matthewjstanford/kratos-energy-monitor/photos/IMG_7349.JPG

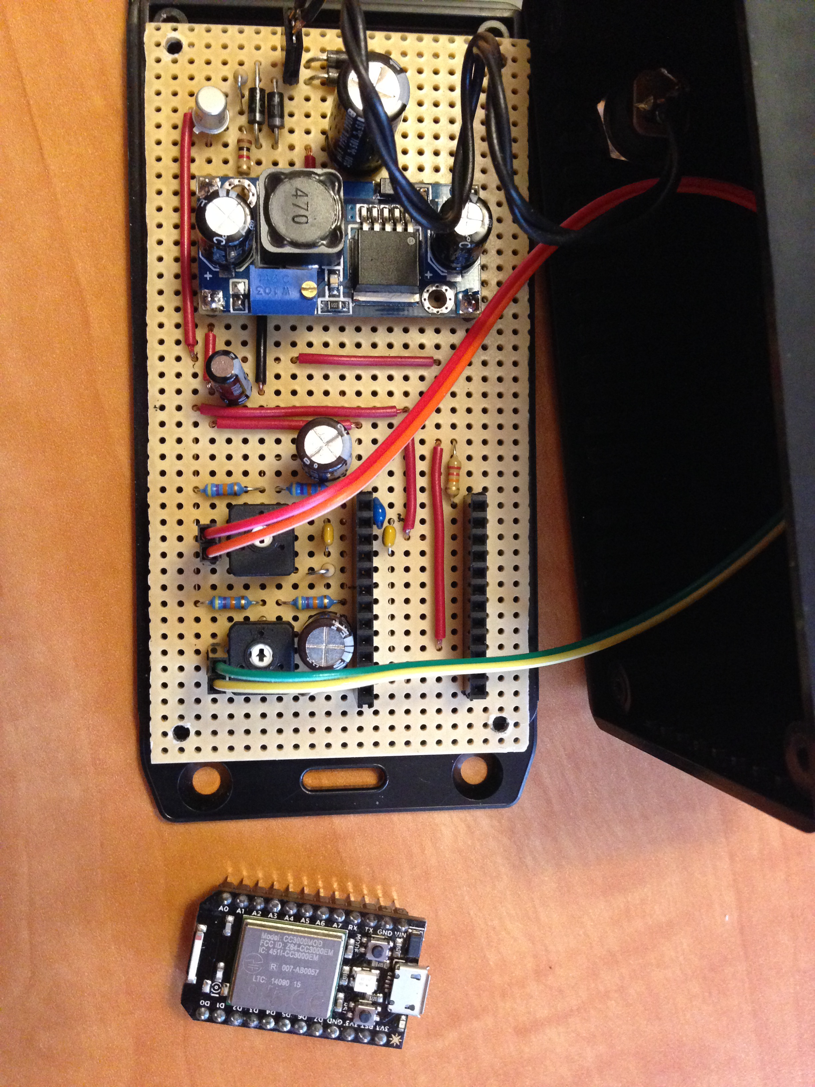
photos/IMG_7349.JPG
