matthewjstanford/kratos-energy-monitor/photos/IMG_7350.JPG

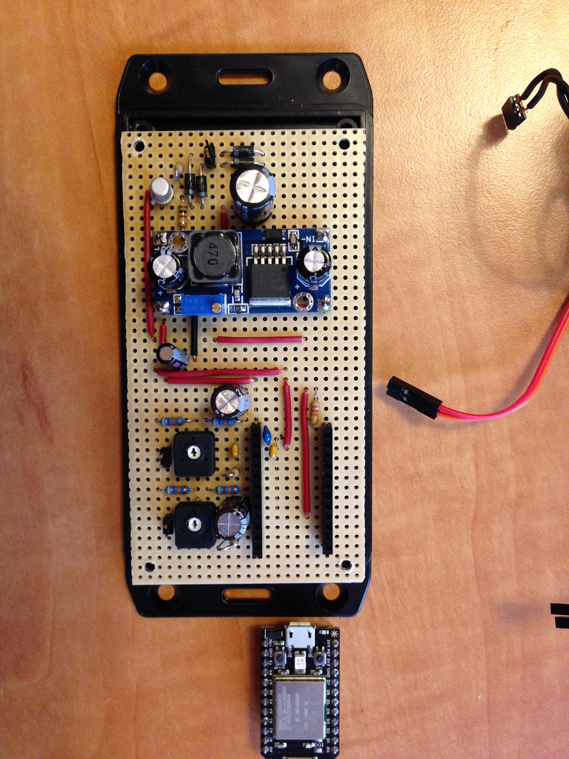
photos/IMG_7350.JPG
