matthewjstanford/kratos-energy-monitor/photos/IMG_7337.JPG

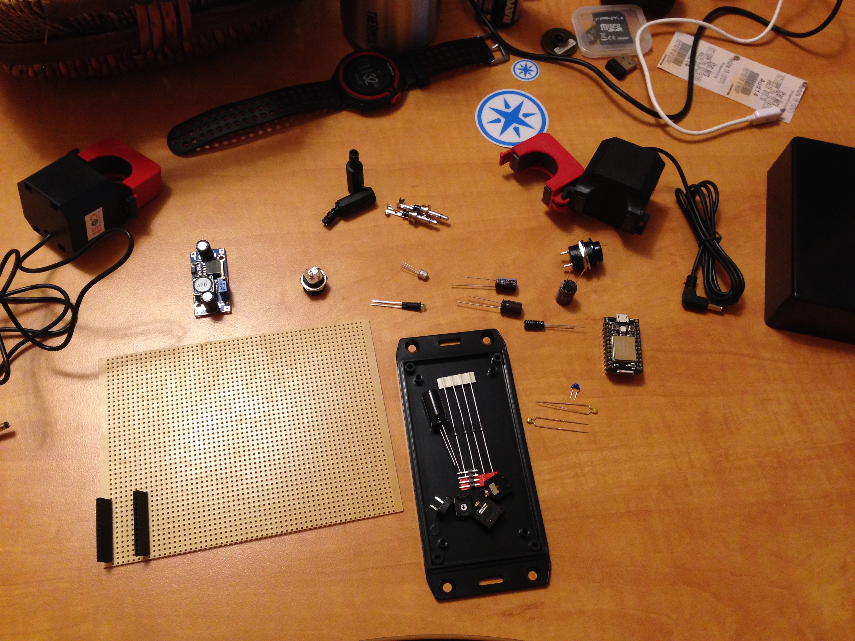
photos/IMG_7337.JPG
