matthewjstanford/kratos-energy-monitor/photos/IMG_7341.JPG

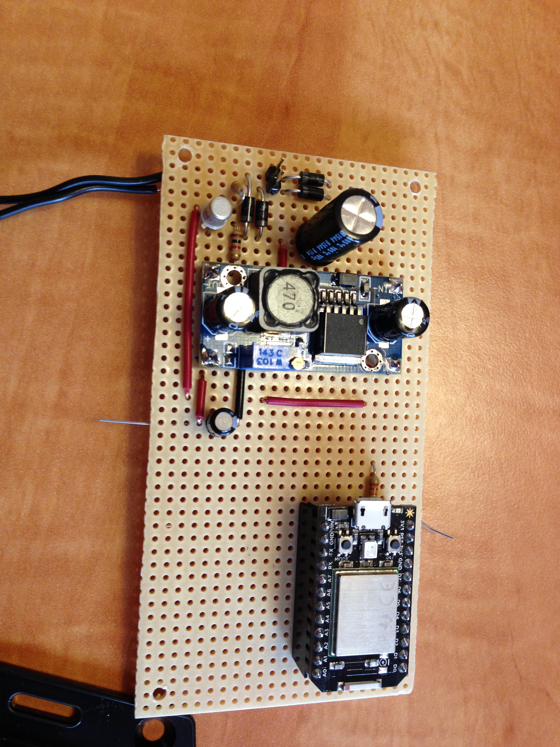
photos/IMG_7341.JPG
