matthewjstanford/kratos-energy-monitor/photos/IMG_7342.JPG

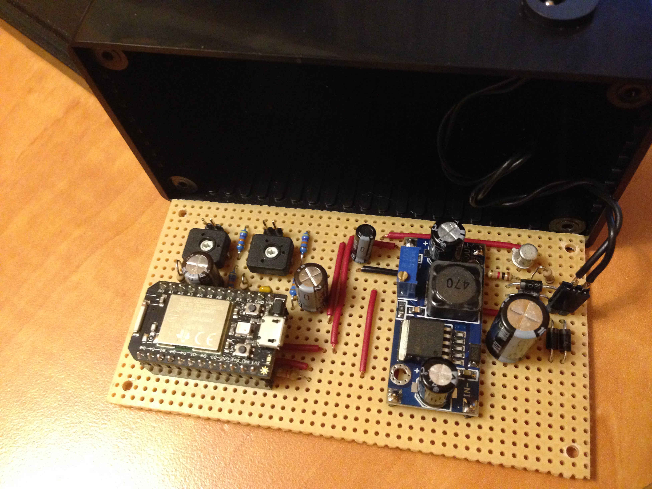
photos/IMG_7342.JPG
