matthewjstanford/kratos-energy-monitor/photos/IMG_7351.JPG

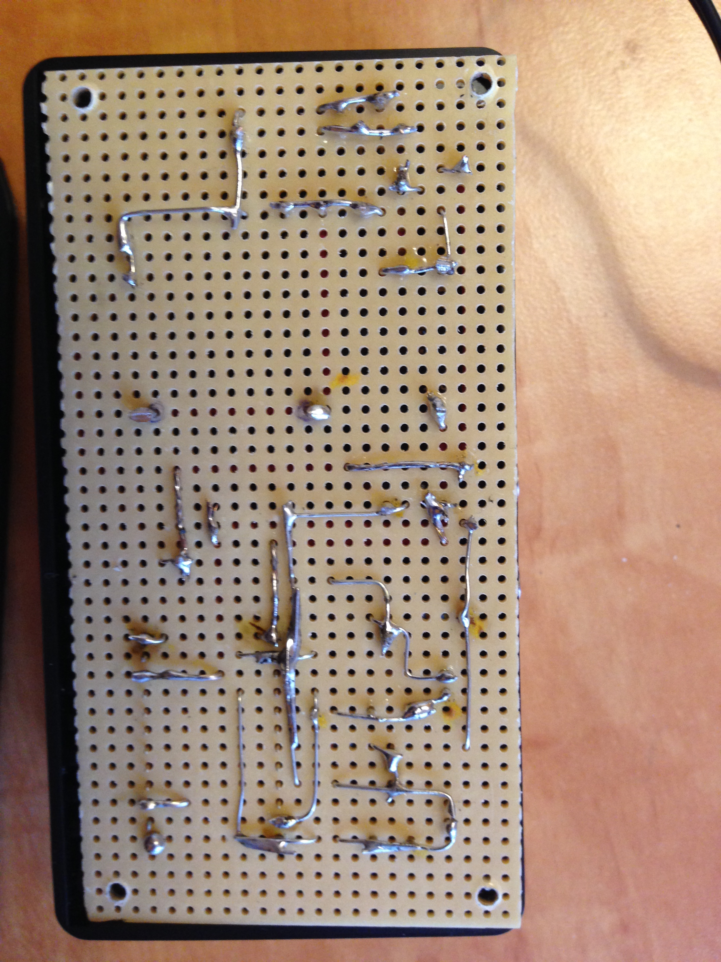
photos/IMG_7351.JPG
