matthewjstanford/kratos-energy-monitor/schematics/NCP3063-converter.sch

## EAGLE design schematics/NCP3063-converter.sch (2016-03-28)

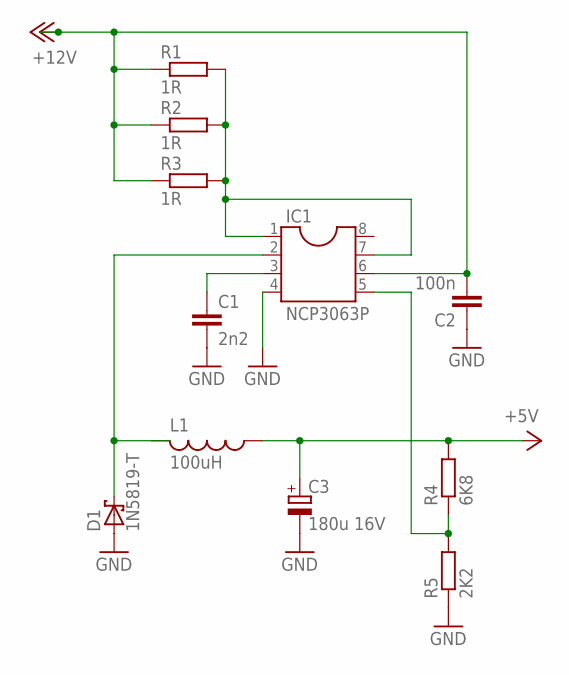
[picture p7: schematic NCP3063-converter.sch]

Parts:
C1: 2n2; C050-045X075
C2: 100n; C050-045X075
C3: 180u 16V; E5R
D1: 1N5819-T; DO41-7.6
IC1: NCP3063P; DIL08
L1: 100uH; 0207/15
R1, R2, R3: 1R; 0309/12
R4: 6K8; 0309/12
R5: 2K2; 0309/12

Connections:
+5V: C3.+, L1.1, R4.2
+12V: C2.2, R1.1, R2.1, R3.1
GND: C1.2, C2.1, C3.-, D1.A, IC1.4, R5.1
unnamed: IC1.1, IC1.7, R1.2, R2.2, R3.2
unnamed: R4.1, R5.2
