matthewjstanford/kratos-energy-monitor/schematics/Spark-power-meter-main.sch

## EAGLE design schematics/Spark-power-meter-main.sch (2016-03-28)

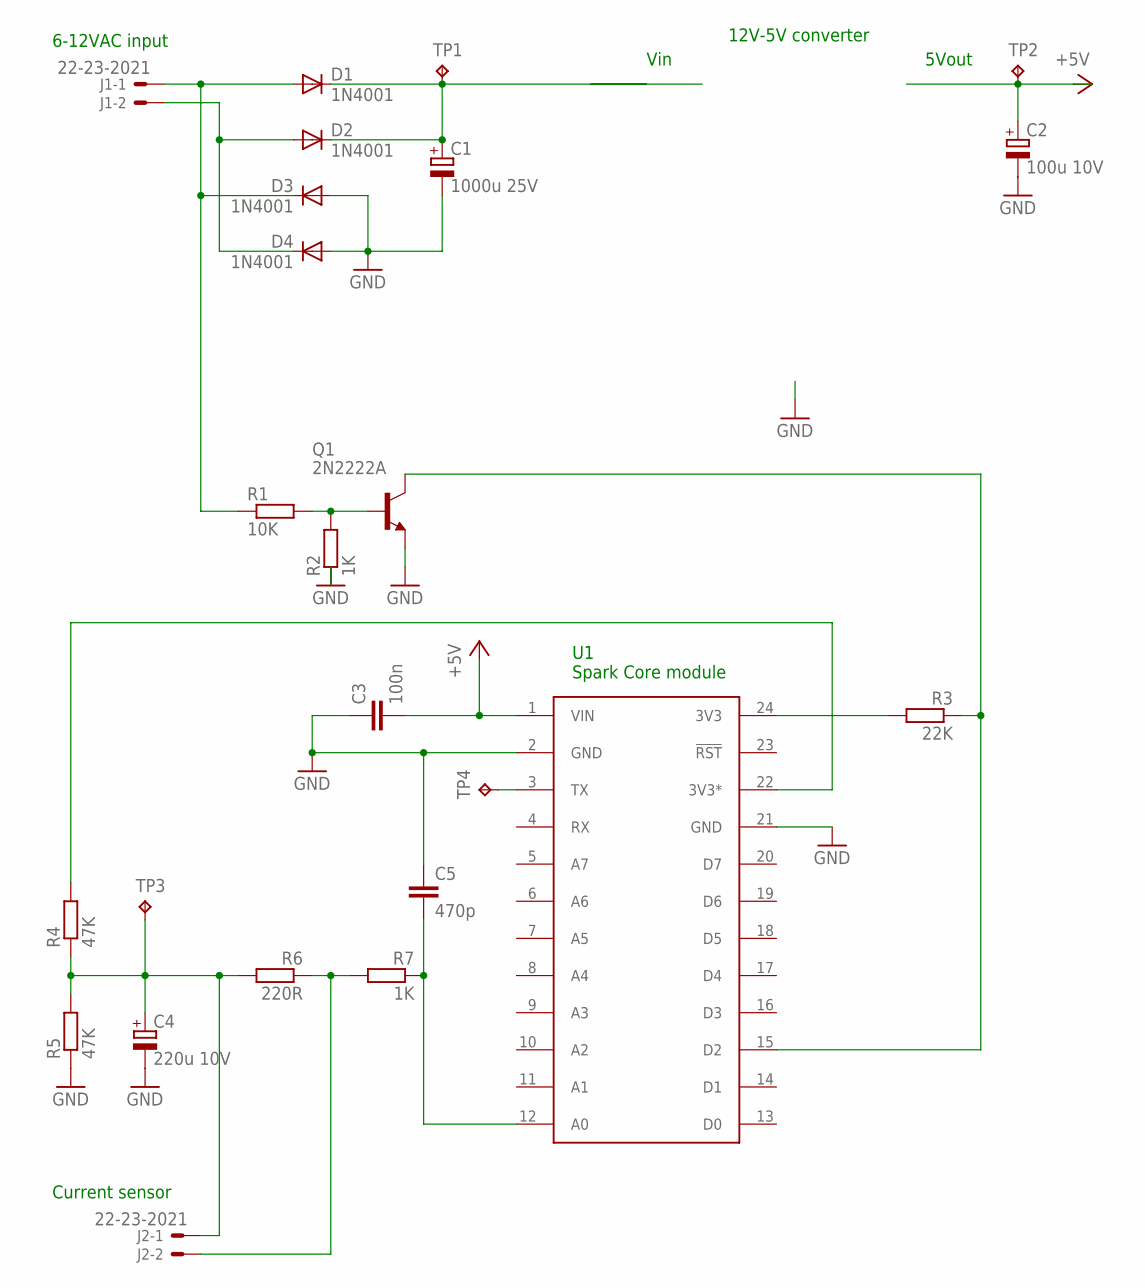
[picture p8: schematic Spark-power-meter-main.sch]

Parts:
C1: 1000u 25V; E5R
C2: 100u 10V; E5R
C3: 100n; C075-032X103
C4: 220u 10V; E5R
C5: 470p; C075-032X103
D1, D2, D3, D4: 1N4001; DO41-10
J1, J2: 22-23-2021
Q1: 2N2222A; TO18
R1: 10K; 0207/10
R2, R7: 1K; 0207/10
R3: 22K; 0207/10
R4, R5: 47K; 0207/10
R6: 220R; 0207/10
TP1, TP2, TP3, TP4: TPB1,27; B1,27
U$1: SPARK_CORECORE; SPARK_CORE

Connections:
+5V: C2.+, C3.2, TP2.TP, U$1.1 (VIN)
+12V: C1.+, D1.C, D2.C, TP1.TP
GND: C1.-, C2.-, C3.1, C4.-, C5.1, D3.A, D4.A, Q1.1 (E), R2.1, R5.1, U$1.2 (GND), U$1.21 (GND)
unnamed: D1.A, D3.C, J1.1, R1.1
unnamed: D2.A, D4.C, J1.2
unnamed: Q1.2 (B), R1.2, R2.2
unnamed: Q1.3 (C), R3.1, U$1.15 (D2)
unnamed: R3.2, U$1.24 (3V3)
unnamed: R4.2, U$1.22 (3V3*)
unnamed: C4.+, J2.1, R4.1, R5.2, R6.2, TP3.TP
unnamed: TP4.TP, U$1.3 (TX)
unnamed: C5.2, R7.1, U$1.12 (A0)
unnamed: J2.2, R6.1, R7.2

Notes on the sheet:
12V-5V converter
Vin
5Vout
6-12VAC input
Current sensor
U1 Spark Core module
