matthewjstanford/kratos-energy-monitor/(notices)

Notices in the files:
MQTT/MQTT.h:
Copyright (c) 2014 Hirotaka Niisato
